cas70240/YM2151_VGM_STM32/(list of files, drawings)

Other design files:
Schematic/YM2151_STM32_VGM.dsn
