cas70240/YM2151_VGM_STM32/Schematic/YM2151_STM32_VGM.kicad_pcb

## KiCad design Schematic/YM2151_STM32_VGM.kicad_pcb (2022-04-13)

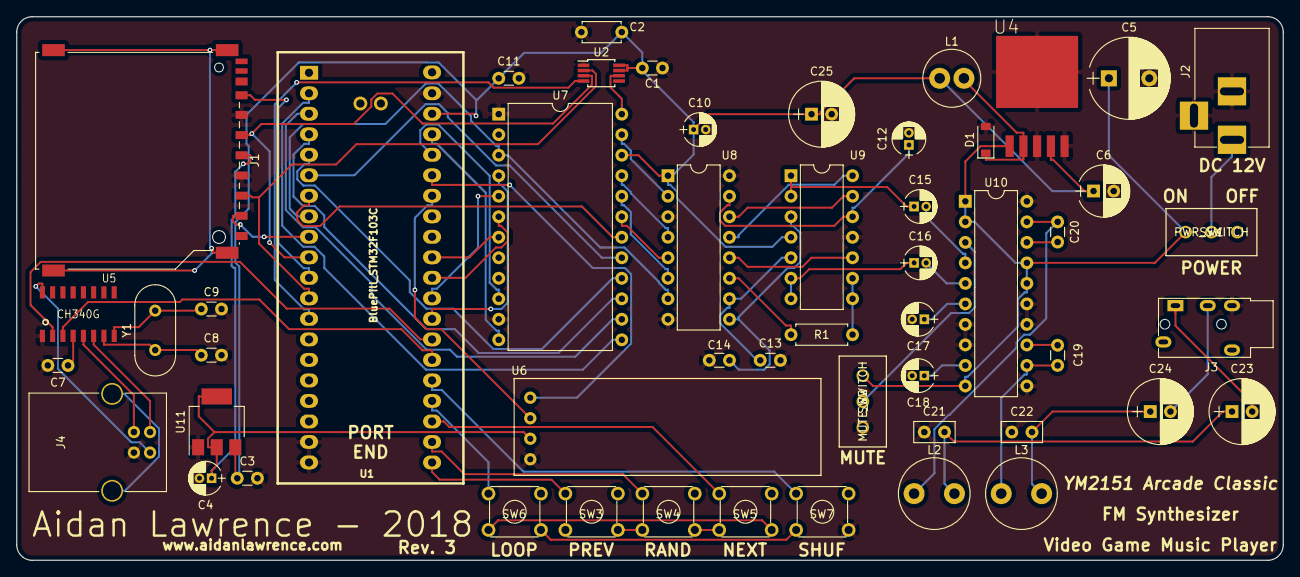
[picture p2: board YM2151_STM32_VGM.kicad_pcb from above]

Board: 2 copper layers, 156.8 x 67.3 mm, 52 parts (0 on the bottom side), 71 nets.

Parts:
C1: 10nF; C_Disc_D3.0mm_W1.6mm_P2.50mm
C2: 1uF; C_Disc_D4.7mm_W2.5mm_P5.00mm
C3, C7, C11: 100nF; C_Disc_D3.0mm_W1.6mm_P2.50mm
C4, C10, C12: 10uF; CP_Radial_D4.0mm_P1.50mm
C5: 680uF; CP_Radial_D10.0mm_P5.00mm
C6: 220uF; CP_Radial_D6.3mm_P2.50mm
C8, C9: 22pF; C_Disc_D3.0mm_W1.6mm_P2.50mm
C13, C14: 3.3nF; C_Disc_D3.0mm_W1.6mm_P2.50mm
C15, C16, C17, C18: 1uF; CP_Radial_D4.0mm_P1.50mm
C19, C20: 0.22uF; C_Disc_D3.0mm_W1.6mm_P2.50mm
C21, C22: 68nF; C_Disc_D5.0mm_W2.5mm_P2.50mm
C23, C24, C25: 1000uF; CP_Radial_D8.0mm_P2.50mm
D1: SS34; D_SOD-123
J1: SD_Card; SD_TE_2041021
J2: Jack_DC+12V; BARREL_JACK
J3: JACK_TRS_6PINS; PJ320E_3.5mm_Jack
J4: USB_B
L1: 33uH; L_Radial_D7.0mm_P3.00mm
L2, L3: 22uH; L_Radial_D8.7mm_P5.00mm_Fastron_07HCP
R1: 100; R_Axial_DIN0207_L6.3mm_D2.5mm_P7.62mm_Horizontal
SW1: PWR_SWITCH; 1825115-1
SW2: MUTE_SWITCH; 1825115-1
SW3: PREV; SW_TH_Tactile_Omron_B3F-10xx
SW4: RAND; SW_TH_Tactile_Omron_B3F-10xx
SW5: NEXT; SW_TH_Tactile_Omron_B3F-10xx
SW6: LOOP; SW_TH_Tactile_Omron_B3F-10xx
SW7: SHUF; SW_TH_Tactile_Omron_B3F-10xx
U1: BluePill_STM32F103C
U2: LTC6903; MSOP-8_3x3mm_Pitch0.65mm
U4: LM2596S-5.0; TO170P1435X465-6N
U5: CH340G; SOIC16
U6: OLED_128x32_I2C; 128x32_OLED_I2C_Module
U7: YM2151; DIP-24_W15.24mm
U8: YM3012; DIP-16_W7.62mm
U9: TL064; DIP-14_W7.62mm
U10: TPA3122D2; DIP-20_W7.62mm
U11: LD1117; SOT-223-3_TabPin2
Y1: 12MHz; Crystal_HC49-U_Vertical

Connections:
+3V3: C4.1, J1.4, U6.2, U11.2
+5V: C1.1, C2.1, C3.1, C6.1, C10.1, C11.1, C25.1, L1.1, U1.38, U2.7, U2.8, U4.4, U7.22, U8.1, U9.4, U11.3
+12V: C5.1, SW1.1, SW2.3, U4.1, U10.1, U10.2, U10.10, U10.16, U10.17
BC: U8.14, U9.13
CH1: C14.1, U8.9, U9.3
CH2: C13.1, U8.10, U9.5
COM: R1.2, U8.11
D0: U1.36, U7.10
D1: U1.37, U7.12
D2: U1.2, U7.13
D3: U1.3, U7.14
D4: U1.4, U7.15
D5: U1.5, U7.16
D6: U1.6, U7.17
D7: U1.7, U7.18
GND: C1.2, C2.2, C3.2, C4.2, C5.2, C6.2, C7.2, C8.2, C9.2, C10.2, C11.2, C12.2, C13.2, C14.2, C17.2, C18.2, C21.1, C22.2, C25.2, D1.2, J1.3, J1.6, J2.2, J2.3, J3.3, J4.4, SW2.1, SW3.3, SW7.4, U1.19, U1.20, U1.39, U2.1, U4.3, U4.5, U4.6, U5.1, U6.1, U7.1, U7.11, U8.3, U8.8, U8.16, U9.11, U10.7, U10.8, U10.11, U10.14, U10.15, U10.20, U11.1
LEFT_OP_OUT: C15.1, U9.1, U9.2
LOOP: SW6.1, U1.24
L_OUT: C23.2, J3.1
MP: U8.13, U9.14
NEXT: SW5.1, U1.23
unnamed: C7.1, U5.4
unnamed: C8.1, U5.7, Y1.1
unnamed: C9.1, U5.8, Y1.2
unnamed: C15.2, U10.4
unnamed: C16.2, U10.5
unnamed: C17.1, U10.6
unnamed: C18.1, U10.9
unnamed: C19.1, L3.1, U10.12
unnamed: C19.2, U10.13
unnamed: C20.1, L2.1, U10.19
unnamed: C20.2, U10.18
unnamed: C21.2, C23.1, L2.2
unnamed: C22.1, C24.1, L3.2
unnamed: D1.1, L1.2, U4.2
unnamed: J2.1, SW1.2
unnamed: J4.1, U5.16
unnamed: J4.2, U5.6
unnamed: J4.3, U5.5
unnamed: R1.1, U9.8, U9.9
unnamed: SW2.2, U10.3
unnamed: SW3.4, SW4.3
unnamed: SW4.4, SW5.3
unnamed: SW5.4, SW6.3
unnamed: SW6.4, SW7.3
unnamed: U2.6, U7.24
unnamed: U7.23, U8.2
PREV: SW3.1, U1.21
RAND: SW4.1, U1.22
RB: C12.1, U8.15, U9.12
RIGHT_OP_OUT: C16.1, U9.6, U9.7
RX: U1.26, U5.3
R_OUT: C24.2, J3.2
SCL: U1.34, U6.3
SDA: U1.35, U6.4
SD_CS: J1.1, U1.9
SH1: U7.20, U8.6
SH2: U7.19, U8.5
SHUF: SW7.1, U1.25
SO: U7.21, U8.4
SPI_MISO: J1.7, U1.11
SPI_MOSI: J1.2, U1.12, U2.2
SPI_SCLK: J1.5, U1.10, U2.3
TX: U1.27, U5.2
YM_A0: U1.28, U7.4
YM_CLOCK_CS: U1.13, U2.4
YM_CS: U1.31, U7.7
YM_IC: U1.8, U7.3, U8.7
YM_RD: U1.30, U7.6
YM_WR: U1.29, U7.5
tBUF: U8.12, U9.10
