cas70240/YM2151_VGM_STM32/src/ringbuffer.h

/*
   ringbuffer.h - yet another version of ringbuffer_t c++ template

   Desc: This template class creates a ringbuffer with arbitrary types. Provides push
         and pop methods for adding and removing items.  Access function for checking
         the number of items in the buffer, capacity and full or empty methods
         provide safe access to the info.

         This version has been optimized for the msp430-gcc and stm32. It doesn't use disable
         or enable any interrupts. It is safe nonetheless for use when there is a single
         writer and single reader. This is common when using an interrupt and the main
         line thread working together to move data in and out of peripherals on demand.

   Version: 1.0.3
   Created: Jul-24-2012
    Author: rick@kimballsoftware.com
      Date: 02-28-2013

   =========================================================================
    Copyright © 2012-2016 Rick Kimball

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
    Jul-14-2016: rick@kimballsoftware.com removed extra stuff not needed for stm32
                 formatted using auto format in arduino ide

*/

#ifndef RINGBUFFER_T_H_
#define RINGBUFFER_T_H_
#include <stdint.h>

/**
   struct_is_power_of_two - power of 2 checker
     enforce at compile time that SIZE is power of 2 and >= 2
*/

template<unsigned SIZE>
struct is_power_of_two {
  enum {val = (SIZE >= 2) & (SIZE > 1) & !(SIZE & (SIZE - 1))};
  static const unsigned badSIZE[(val == 1) ? 1 : -1]; // SIZE is not a power of 2 if you an error here.
};

/**
   uint16x2_t - a union containing 16 bit head and tail offsets into the ring buffer. The union
                allows the c code to grab both values with one assembler instruction access.

*/
union uint16x2_t {
  // access as 32 bit
  unsigned long both;
  // -- or as 2 16 bit values --
  struct {
    unsigned head: 16;
    unsigned tail: 16;
  };
};

/**
   ringbuffer_t - provide a circular_buffer without disabling interrupts
      expects a power of 2 container, and only one reader and one writer
      container capacity SIZE-1
*/

template <
  typename T,                     /* works with any type */
  uint16_t SIZE,                  /* how many elements-1 must be power of 2 */
  typename POP_T = int16_t,       /* return type of pop_front */
  POP_T EMPTY_ELEM = (POP_T) - 1  /* default return value when empty */
  >
struct ringbuffer_t {

  // --- private structure data ---
  // although variables are accessible because this is a struct
  
  volatile uint16x2_t offsets; // comes first so we can use 0 offset to variables
                               // for fastest access
  T elements[SIZE];         

  enum { CAPACITY = SIZE - 1 }; // leave one slot open

  is_power_of_two<SIZE> check_buffer_size; // your SIZE is not a power of 2, if you get an error here

  // --- public methods ---

  // write access zeros out head and tail
  inline void clear(void ) {
    offsets.both = 0;
  }

  // return the count of used slots
  size_t available() {
    register uint16x2_t temp = { offsets.both };

    temp.both = (temp.head - temp.tail) & CAPACITY;

    return temp.both;
  }

  // return maximum number of slots available
  size_t capacity() {
    return CAPACITY;
  }

  // returns true when there is no used slots
  bool inline empty() {
    return !available();
  }

  // returns true when all slots used
  bool inline full() {
    return available() == capacity();
  }

  /*
      push_back() - adds an element to the end of the queue

      Note: affects head, reads tail, element ignored if overflow ~300 ns @72MHz
  */
  void push_back(const T element) {
    register uint16_t temp_head = offsets.head;

    elements[temp_head++] = element;
    temp_head &= CAPACITY;
    if ( !(temp_head == offsets.tail) ) { // !full
      offsets.head = temp_head;
    }

    return;
  }

  // no bounds check version, affects head ~250 ns @72MHz
  void push_back_nc(const T element) {
    register uint16_t temp_head = offsets.head;

    elements[temp_head++] = element;
    offsets.head = temp_head & CAPACITY;
    return;
  }


  // affects tail, reads head
  POP_T pop_front(void) {
    register uint16x2_t temp = { offsets.both };

    if ( (temp.head - temp.tail) & CAPACITY ) { // !empty
      POP_T elem = elements[temp.tail++];
      offsets.tail = temp.tail & CAPACITY;
      return elem;
    }

    return EMPTY_ELEM; // on underflow return default element
  }

  // no bounds check, affects tail
  POP_T pop_front_nc(void) {
    register uint16_t temp_tail = offsets.tail;

    POP_T elem = elements[temp_tail++];
    offsets.tail = temp_tail & CAPACITY;
    return elem;
  }

};

#endif /* RINGBUFFER_T_H_ */
